KSP4EVER/hv_psu_v100/README.md

# hv_psu_v100
High Voltage Power Supply for Photo Multiplier Tubes
