KSP4EVER/hv_psu_v100/HW/hv_psu_v100.pdf

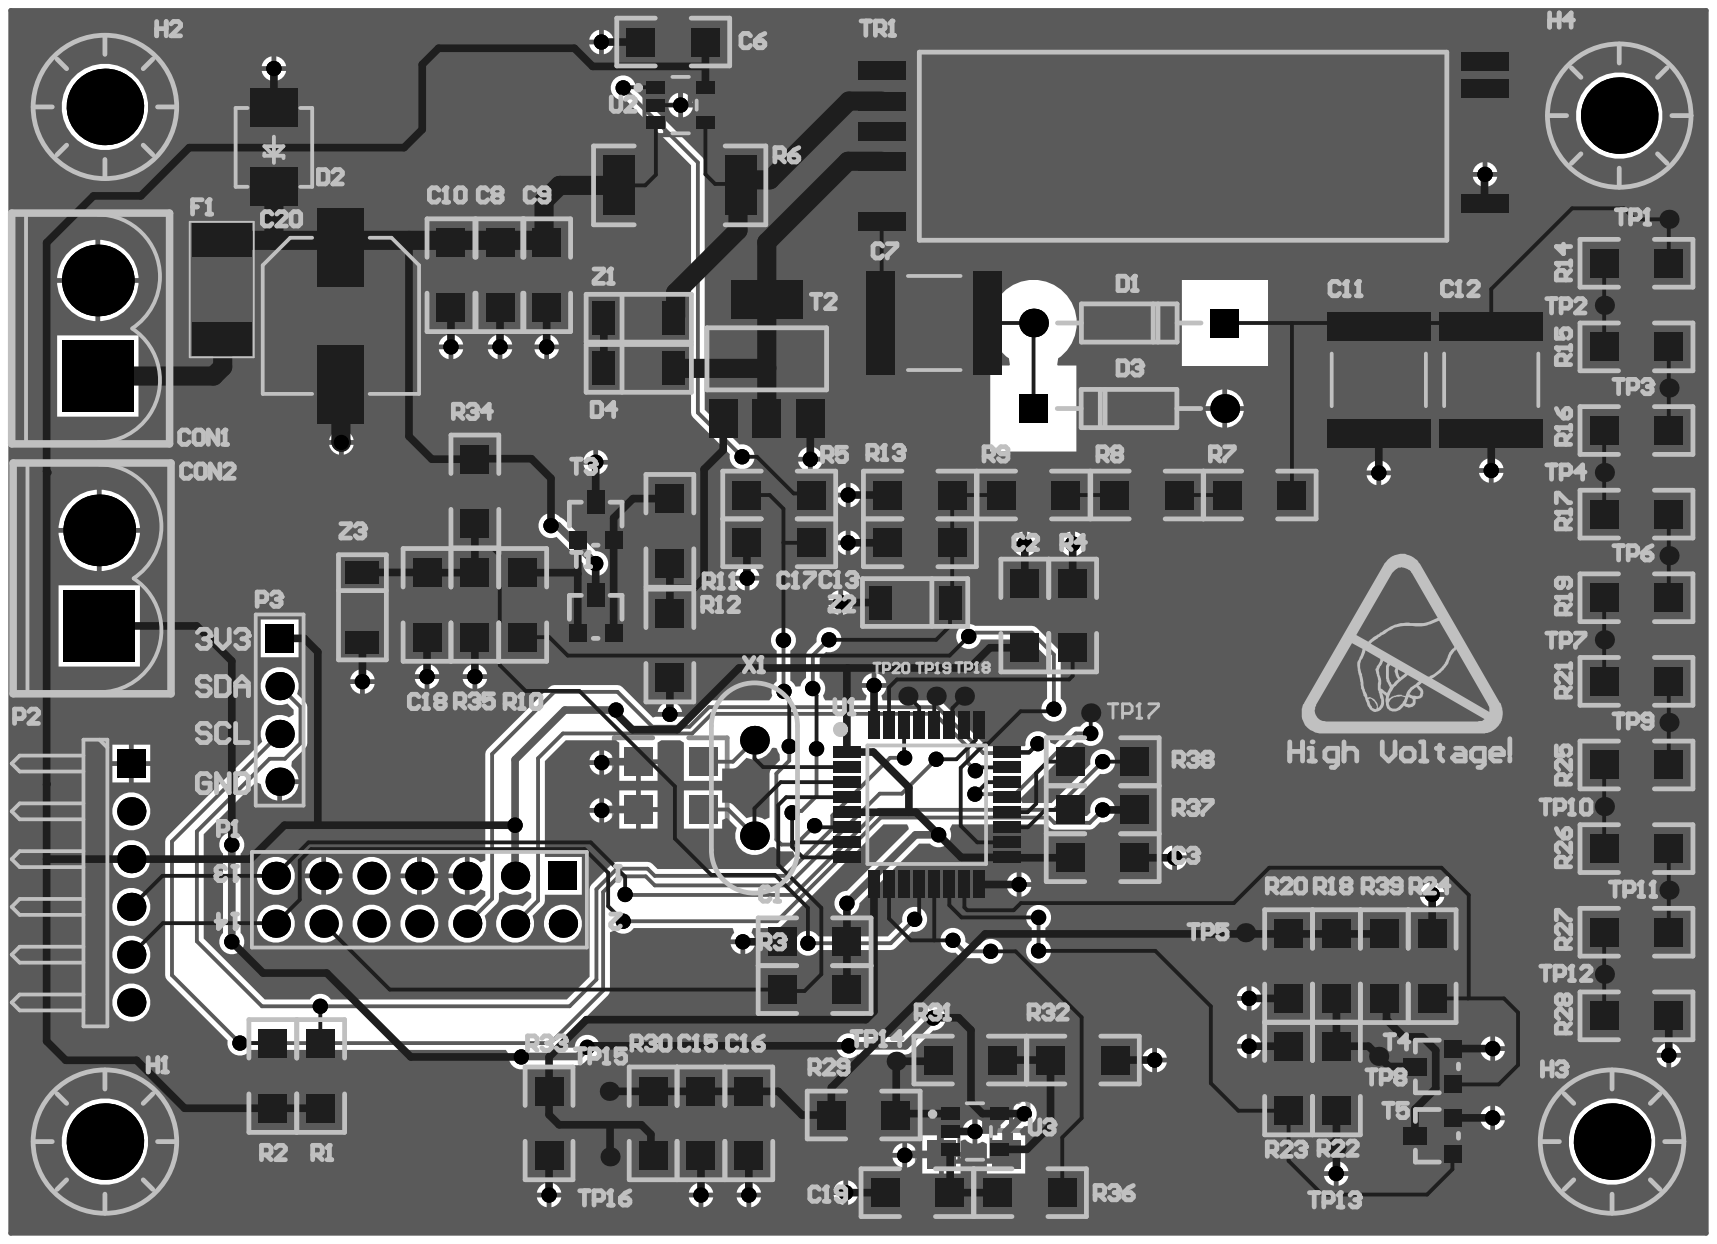
[picture p15: page 1]
