KSP4EVER/hv_psu_v100/(list of files, drawings)

Other design files:
HW/hv_psu_v100.PcbDoc
HW/hv_psu_v100.PrjPcb
HW/hv_psu_v100_CON.SchDoc
HW/hv_psu_v100_FLYBACK.SchDoc
HW/hv_psu_v100_FRP.SchDoc
HW/hv_psu_v100_LINREG.SchDoc
HW/hv_psu_v100_MAIN.SchDoc
HW/hv_psu_v100_MCU.SchDoc
HW/hv_psu_v100_TESTLOAD.SchDoc
