KSP4EVER/hv_psu_v100/SW/Core/Src/main.c

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
/* Includes ------------------------------------------------------------------*/
#include "main.h"

ADC_HandleTypeDef hadc1;
DMA_HandleTypeDef hdma_adc1;

DAC_HandleTypeDef hdac;

I2C_HandleTypeDef hi2c1;

TIM_HandleTypeDef htim1;
TIM_HandleTypeDef htim2;

UART_HandleTypeDef huart1;

/* USER CODE BEGIN PV */
volatile uint32_t val = 0;
volatile float div_const = 0.313121;
volatile uint32_t uki = 0;
volatile float uref = 0;
volatile float Ap = 0.1;
volatile float ufb = 0;
volatile float duty = 0.0;
volatile float error = 0.0;
/* USER CODE END PV */

void SystemClock_Config(void);
static void MX_GPIO_Init(void);
static void MX_DMA_Init(void);
static void MX_ADC1_Init(void);
static void MX_DAC_Init(void);
static void MX_I2C1_Init(void);
static void MX_USART1_UART_Init(void);
static void MX_TIM1_Init(void);
static void MX_TIM2_Init(void);
/* USER CODE BEGIN 0 */
float v = 0 ;
float x_err_prev = 0 ;
float K_PD = 2.0;
float K_ID = 0.0001;
float V_MAX = 1500;
float V_MIN = 0;

float pi_controller (float x_err )
{
	float integrator = K_PD*K_ID*x_err;



	v = v+integrator+K_PD*(x_err-x_err_prev);

	if ( v > V_MAX)
	{
		v = V_MAX;
	}
	else if ( v < V_MIN)
	{
		v = V_MIN;
	}
	x_err_prev = x_err ;
	return v ;
}



void HAL_TIM_PeriodElapsedCallback(TIM_HandleTypeDef *htim)
{
	error = uref - ufb;
	htim1.Instance->CCR1 = (uint32_t)pi_controller(error);

	/*
	if(error > 0)
	{
		duty = Ap*error;
	}
	else if (error < 0)
	{

	}
	*/
	  /*if(ufb < uref)
	  {
		  //htim1.Instance->CCR1 = Ap*(uref - adc_val);
		  //if(htim1.Instance->CCR1 != 1000) htim1.Instance->CCR1 = htim1.Instance->CCR1+10;

	  }
	  if(ufb > uref)
	  {
		  //htim1.Instance->CCR1 = 0;
		  //if(htim1.Instance->CCR1 >= 40) htim1.Instance->CCR1 = htim1.Instance->CCR1-40;
	  }
	  */
	  uint32_t adc_val = 0;
	  HAL_ADC_Start(&hadc1);
	  HAL_ADC_PollForConversion(&hadc1, 10); // poll for conversion
	  adc_val = HAL_ADC_GetValue(&hadc1); // get the adc value
	  HAL_ADC_Stop(&hadc1); // stop adc

	  ufb = 991.0*((float)adc_val/1024)*3.25;

	 /* float uerr = (float)uki-ufb;
	  htim1.Instance->CCR1 = (uint32_t)pi_controller(uerr);
*/



}
/* USER CODE END 0 */

/**
  * @brief  The application entry point.
  * @retval int
  */
int main(void)
{
  /* MCU Configuration--------------------------------------------------------*/

  /* Reset of all peripherals, Initializes the Flash interface and the Systick. */
  HAL_Init();

  /* Configure the system clock */
  SystemClock_Config();

  /* Initialize all configured peripherals */
  MX_GPIO_Init();
  MX_DMA_Init();
  MX_ADC1_Init();
  MX_DAC_Init();
  MX_I2C1_Init();
  MX_USART1_UART_Init();
  MX_TIM1_Init();
  MX_TIM2_Init();
  /* USER CODE BEGIN 2 */


  HAL_TIM_Base_Start_IT(&htim2);

  //htim1.Instance->CCR1 = 30;
  HAL_TIM_PWM_Start(&htim1, TIM_CHANNEL_1);
  /* USER CODE END 2 */

  /* Infinite loop */
  /* USER CODE BEGIN WHILE */
  while (1)
  {
	  //uint8_t data[] = "HELLO WORLD \r\n";
	  volatile char Rx_data[32] = "";
	  volatile char command[16] = "";
	  volatile char data[16] = "";


	  HAL_UART_Receive(&huart1, (uint8_t*)Rx_data, 32, 100);
	  sscanf(Rx_data,"%s %i", command,&val);

	  if(strcmp("Set_DAC",command) == 0)
	  {
		  sprintf(data,"%d",val);
		  HAL_DAC_SetValue(&hdac, DAC_CHANNEL_1, DAC_ALIGN_12B_R, val);
		  HAL_UART_Transmit(&huart1, (uint8_t*)data, sizeof (data), 10);

	  }
	  if(strcmp("Get_DAC",command) == 0)
	  {
		  sprintf(data,"%d",val);
		  HAL_UART_Transmit(&huart1, (uint8_t*)data, sizeof(data), 10);
	  }
	  if(strcmp("Set_SW1",command) == 0)
	  {
		  HAL_GPIO_WritePin(GPIOB, GPIO_PIN_0, val);
	  }

	  if(strcmp("Set_Duty",command) == 0)
	  {
		  htim1.Instance->CCR1 = val;
	  }

	  if(strcmp("Set_HW",command) == 0)
	  {
		  sprintf(data,"%d",val);
		  HAL_UART_Transmit(&huart1, (uint8_t*)data, sizeof(data), 10);
		  uki = (uint32_t)val;

		  // uref = (uint32_t)(div_const*(float)uki);
		  uref = (float)uki - 40.0;
		  sprintf(data,"%d",uref);
		  HAL_UART_Transmit(&huart1, (uint8_t*)data, sizeof(data), 10);

	  }
	  sprintf(data,"%d\n",htim1.Instance->CCR1);
	  HAL_UART_Transmit(&huart1, (uint8_t*)data, sizeof(data), 10);

    /* USER CODE END WHILE */

    /* USER CODE BEGIN 3 */
  }


  /* USER CODE END 3 */
}

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
