KSP4EVER/hv_psu_v100/SW/hv_psu_controller.ioc

Mcu.UserName=STM32F301K6Tx
PA1.Signal=ADC1_IN2
PA10.Signal=USART1_RX
PA13.Signal=SYS_JTMS-SWDIO
PA14.Signal=SYS_JTCK-SWCLK
PA15.Signal=I2C1_SCL
PA3.Signal=ADC1_IN4
PA4.Signal=COMP_DAC1_group
PA8.Signal=S_TIM1_CH1
PA9.Signal=USART1_TX
PB0.GPIO_Label=LOAD_SW1
PB0.Signal=GPIO_Output
PB7.Signal=I2C1_SDA
PF0-OSC_IN.Signal=RCC_OSC_IN
PF1-OSC_OUT.Signal=RCC_OSC_OUT
