KSP4EVER/hv_psu_v100/(commit log)

2023-09-26 LIN_REG created, CubeIDE project created Signed-off-by: KSP4EVER <szabomihaly2000@gmail.com>
    [hv_psu_v100_FLYBACK.SchDoc, hv_psu_v100_LINREG.SchDoc, hv_psu_v100_MCU.SchDoc, hv_psu_v100_TESTLOAD.SchDoc]
2023-10-02 PCB created, HW review completed
    [hv_psu_v100.PcbDoc, hv_psu_v100.PrjPcb, hv_psu_v100_FLYBACK.SchDoc, hv_psu_v100_FRP.SchDoc, hv_psu_v100_LINREG.SchDoc, hv_psu_v100_MAIN.SchDoc, hv_psu_v100_MCU.SchDoc, hv_psu_v100_TESTLOAD.SchDoc]
2023-10-02 PCB pre-placement
    [hv_psu_v100.PcbDoc, hv_psu_v100_FLYBACK.SchDoc, hv_psu_v100_LINREG.SchDoc]
2023-10-10 Initial PCB route complete Signed-off-by: KSP4EVER <szabomihaly2000@gmail.com>
    [hv_psu_v100.PcbDoc, hv_psu_v100_FLYBACK.SchDoc, hv_psu_v100_MCU.SchDoc, hv_psu_v100_TESTLOAD.SchDoc]
2023-11-11 add full SW dir, update SYM and HW dir
    [hv_psu_v100.PcbDoc, hv_psu_v100.PrjPcb, hv_psu_v100_CON.SchDoc, hv_psu_v100_FLYBACK.SchDoc, hv_psu_v100_MAIN.SchDoc, hv_psu_v100_MCU.SchDoc, hv_psu_v100_TESTLOAD.SchDoc]
2023-11-13 tested: MCU code upload and UART interface
2023-11-14 Added DAC controll over UART
2023-11-15 added pcb design chapter
2023-11-15 added Draftsman doc
    [hv_psu_v100.PcbDoc, hv_psu_v100.PrjPcb]
2023-11-16 Added load switching to Low Voltage PSU
2023-11-16 PrjPcb saved
    [hv_psu_v100.PrjPcb]
2023-11-23 timer code -> write started
2023-11-23 claculated deltad -> output voltage
